alesimattia/Weather-Station-IN_OUT-Esp32-WiFi-IAQ/docs/ESP32_38 pin.jpg

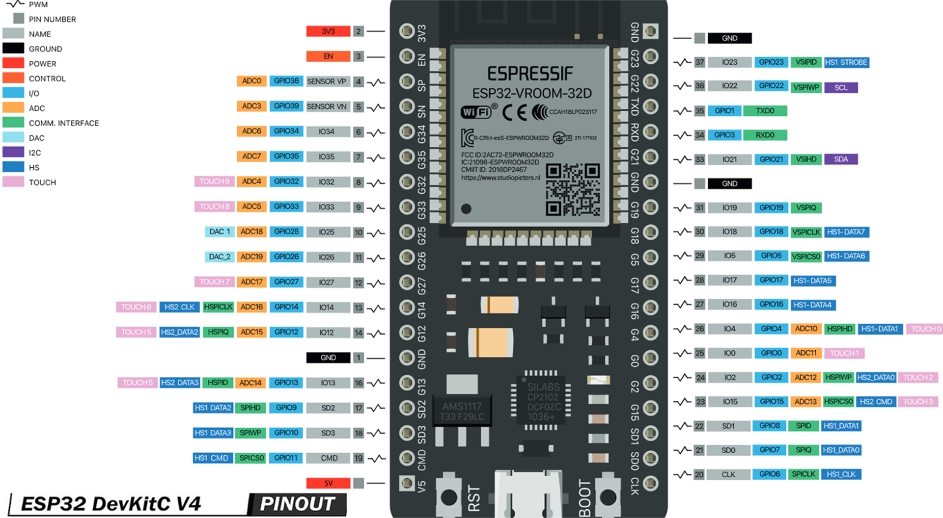
docs/ESP32_38 pin.jpg
