alesimattia/Weather-Station-IN_OUT-Esp32-WiFi-IAQ/docs/ESP32_DevKitC-v4-pinout.jpg

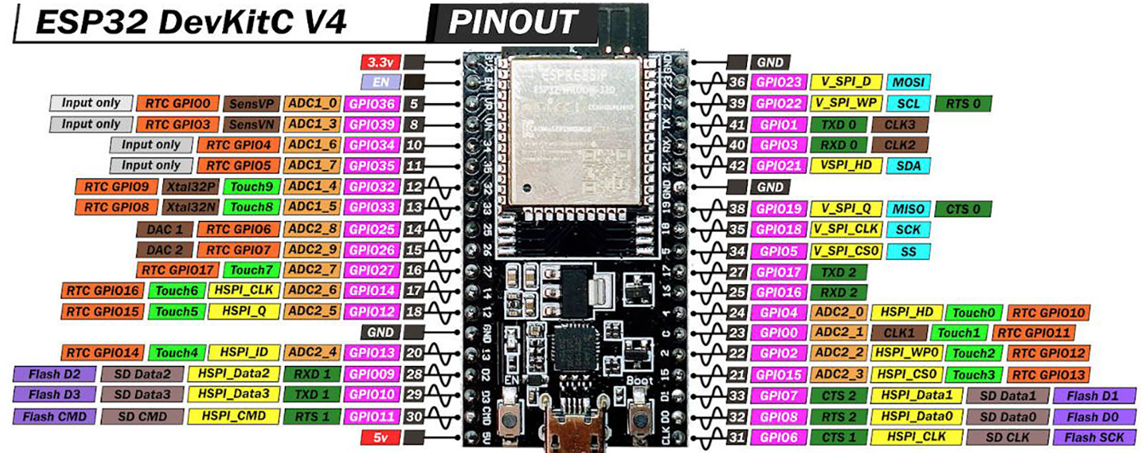
docs/ESP32_DevKitC-v4-pinout.jpg
