alesimattia/Weather-Station-IN_OUT-Esp32-WiFi-IAQ/docs/img/air_quality_index.jpg

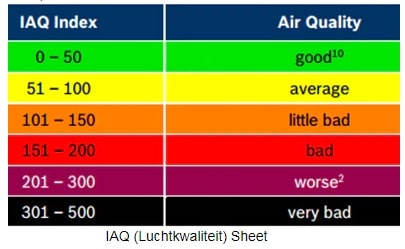
docs/img/air_quality_index.jpg
