alesimattia/Weather-Station-IN_OUT-Esp32-WiFi-IAQ/docs/img/air_quality_ppm.jpg

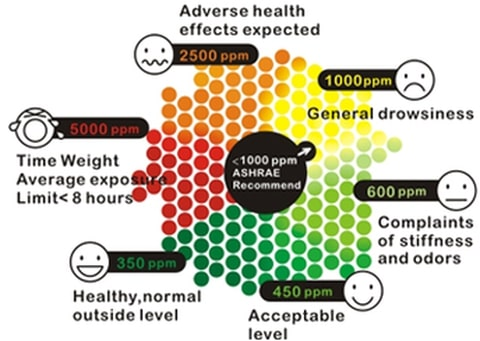
docs/img/air_quality_ppm.jpg
