alesimattia/Weather-Station-IN_OUT-Esp32-WiFi-IAQ/docs/img/bmp280 use cases.jpg

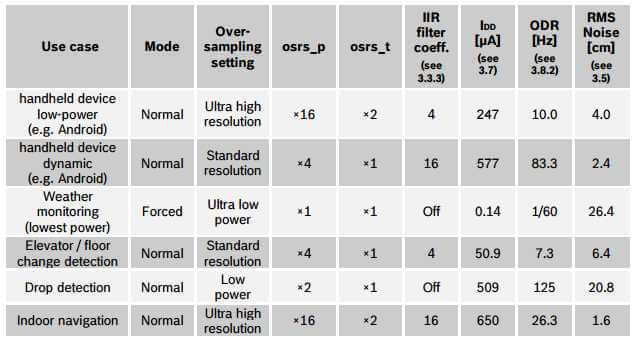
docs/img/bmp280 use cases.jpg
