alesimattia/Weather-Station-IN_OUT-Esp32-WiFi-IAQ/docs/img/board1.JPG

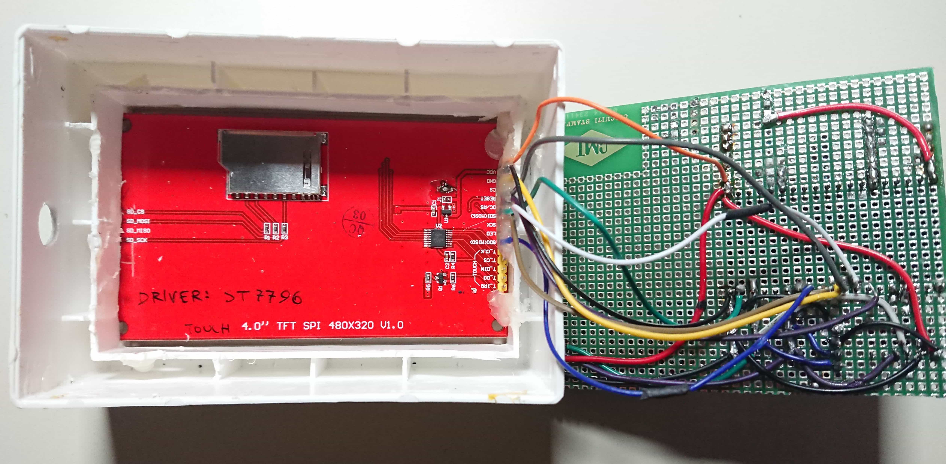
docs/img/board1.JPG
