alesimattia/Weather-Station-IN_OUT-Esp32-WiFi-IAQ/docs/img/board.JPG

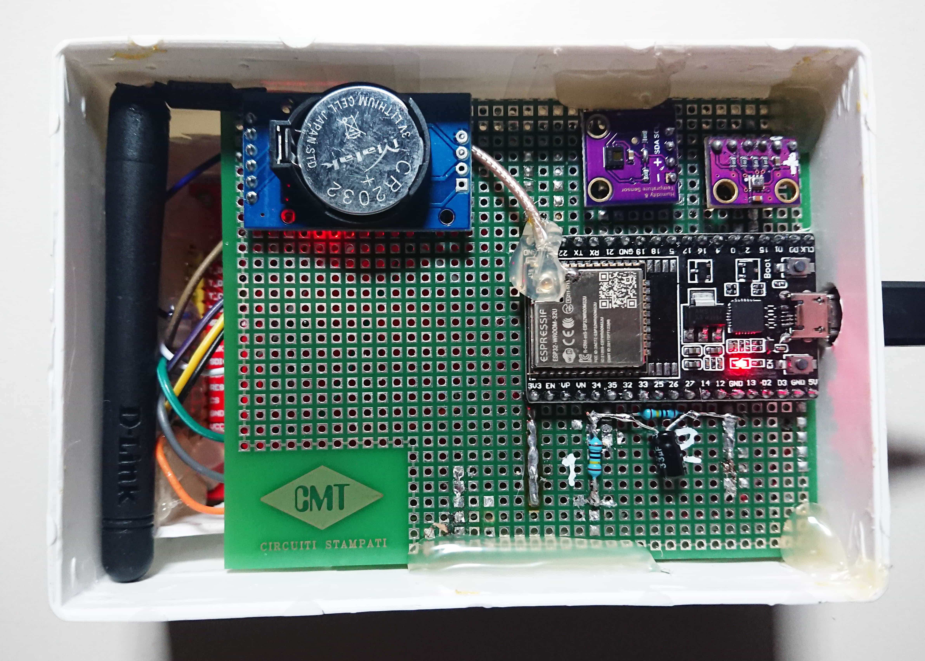
docs/img/board.JPG
