alesimattia/Weather-Station-IN_OUT-Esp32-WiFi-IAQ/docs/img/display.JPG

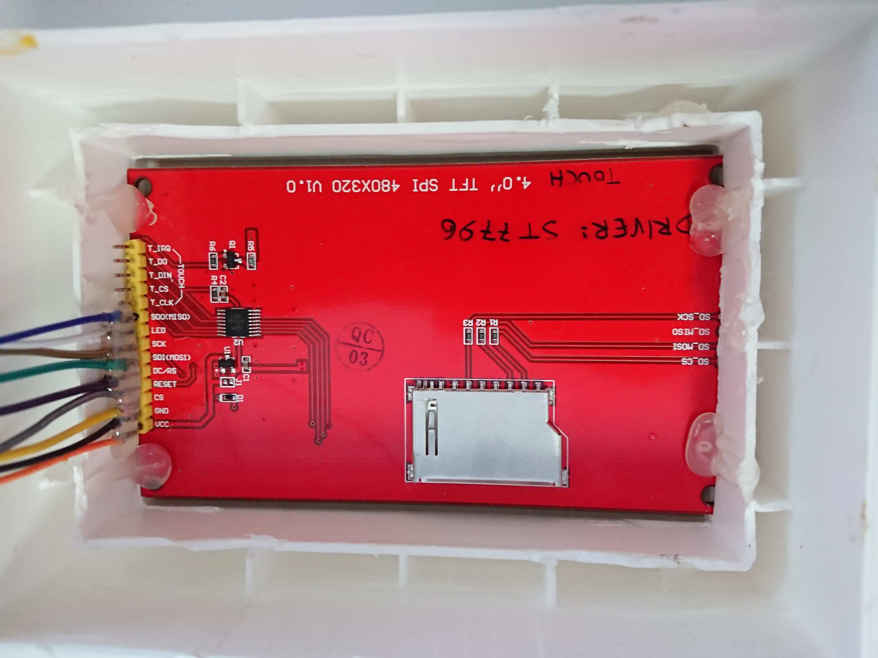
docs/img/display.JPG
