alesimattia/Weather-Station-IN_OUT-Esp32-WiFi-IAQ/docs/img/DSC_1557.JPG

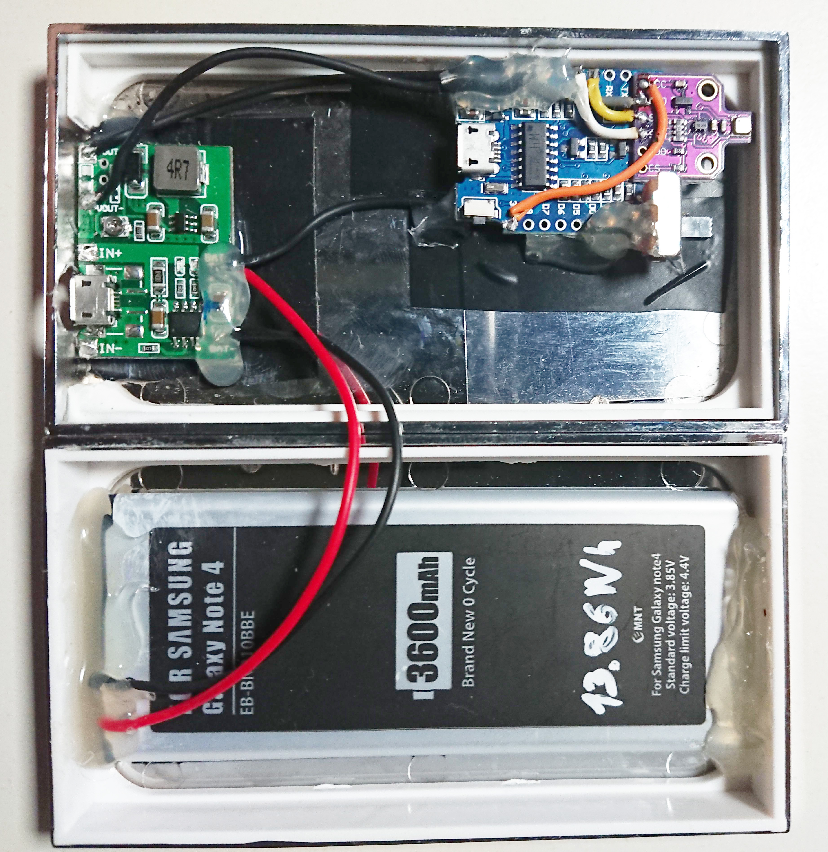
docs/img/DSC_1557.JPG
