alesimattia/Weather-Station-IN_OUT-Esp32-WiFi-IAQ/docs/img/early_ui.JPG

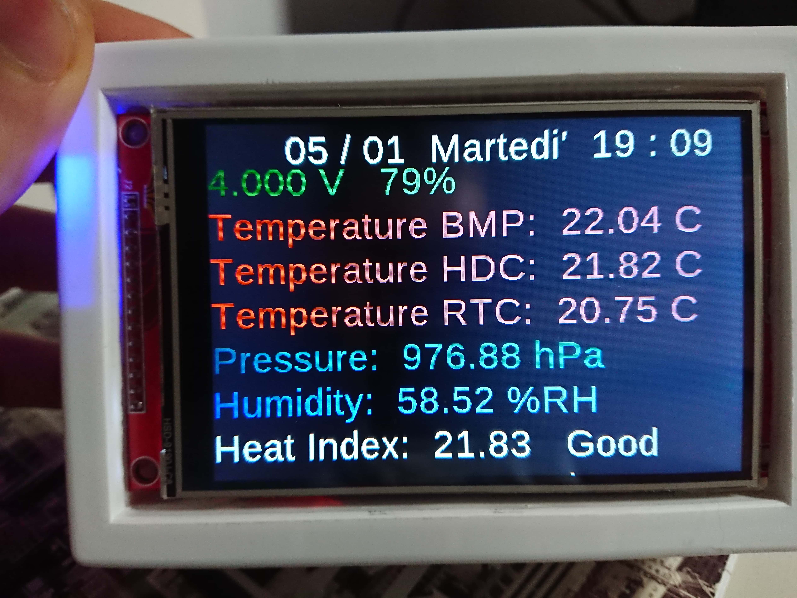
docs/img/early_ui.JPG
