alesimattia/Weather-Station-IN_OUT-Esp32-WiFi-IAQ/docs/img/sleep_modes_8266.jpg

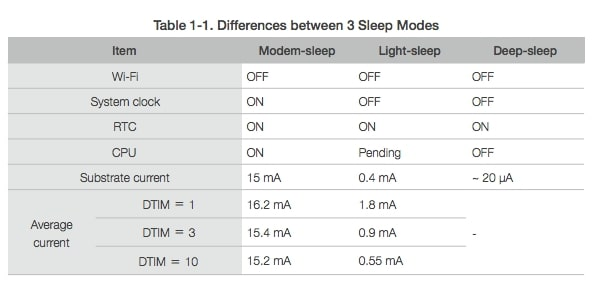
docs/img/sleep_modes_8266.jpg
