alesimattia/Weather-Station-IN_OUT-Esp32-WiFi-IAQ/docs/img/wifi_powe_consumption_8266.jpg

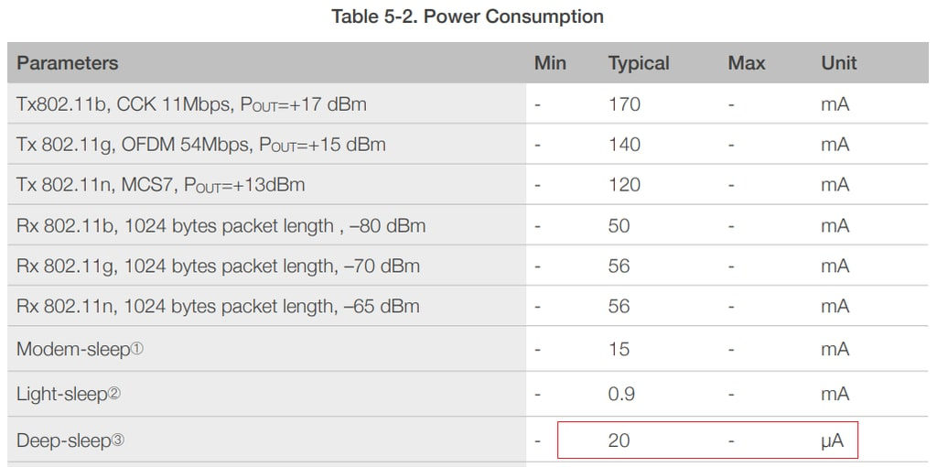
docs/img/wifi_powe_consumption_8266.jpg
