alesimattia/Weather-Station-IN_OUT-Esp32-WiFi-IAQ/docs/img/test1.JPG

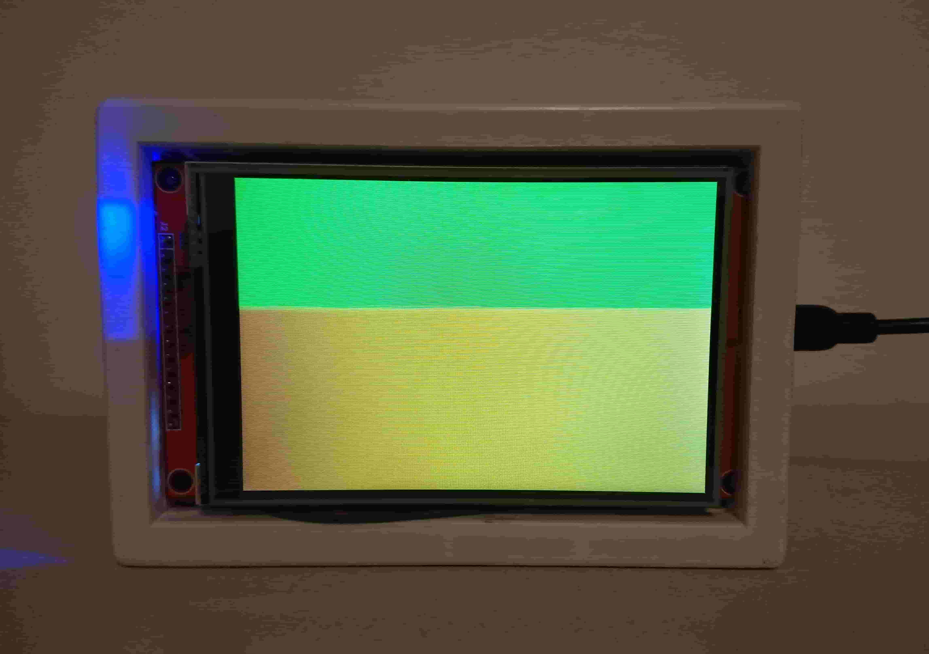
docs/img/test1.JPG
