alesimattia/Weather-Station-IN_OUT-Esp32-WiFi-IAQ/docs/img/test2.JPG

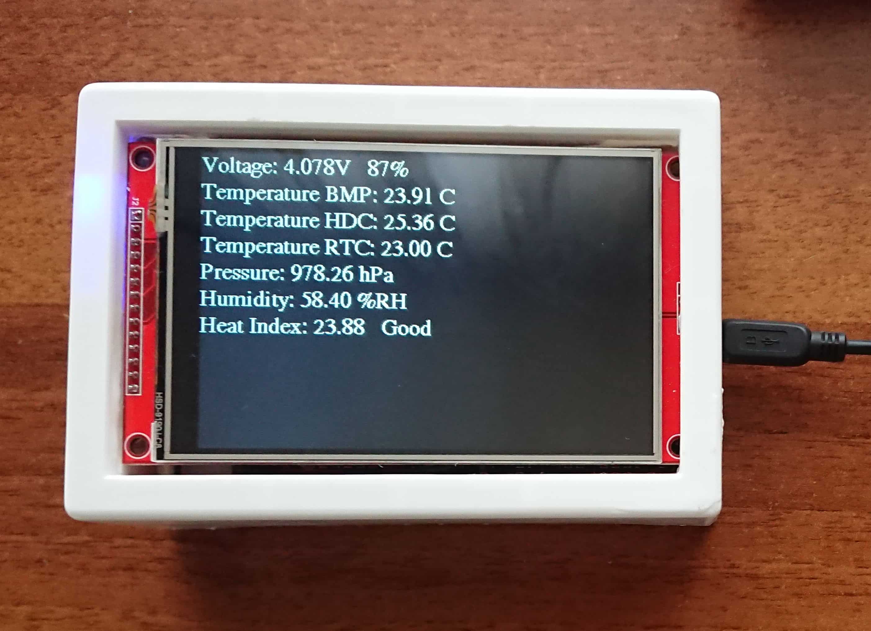
docs/img/test2.JPG
