alesimattia/Weather-Station-IN_OUT-Esp32-WiFi-IAQ/Custom_font.h

// Created by http://oleddisplay.squix.ch/ Consider a donation


/** Best font. located in main project directory. #include "Custom_font.h" */

/******************************************* GENERAL USAGE (Date and sensor data) **************************************************************/

const uint8_t URW_Gothic_L_Book_41Bitmaps[] PROGMEM = {

	// Bitmap Data:
	0x00, // ' '
	0xEE,0xEE,0xEE,0xEE,0xEE,0xEE,0xEE,0xEE,0xEE,0xEE,0xEE,0x00,0x0E,0xEE,0xEE, // '!'
	0xC6,0xC6,0xC6,0xC6,0xC6,0xC6,0xC6,0xC6,0xC6, // '"'
	0x00,0xC0,0x70,0x01,0x80,0xC0,0x07,0x01,0x80,0x0E,0x07,0x00,0x1C,0x0E,0x00,0x30,0x1C,0x00,0x60,0x30,0x01,0xC0,0x60,0x7F,0xFF,0xFC,0xFF,0xFF,0xF9,0xFF,0xFF,0xF0,0x18,0x0E,0x00,0x30,0x18,0x00,0xE0,0x30,0x01,0xC0,0xE0,0x03,0x81,0xC0,0x06,0x03,0x81,0xFF,0xFF,0xF3,0xFF,0xFF,0xE7,0xFF,0xFF,0xC0,0xE0,0x70,0x01,0xC0,0xE0,0x03,0x01,0xC0,0x06,0x03,0x00,0x1C,0x06,0x00,0x38,0x1C,0x00,0x70,0x38,0x00,0xC0,0x70,0x01,0x80,0xE0,0x07,0x01,0x80,0x00, // '#'
	0x01,0xC0,0x00,0xE0,0x00,0x70,0x00,0x3C,0x00,0xFF,0x80,0xFF,0xE0,0xF0,0x78,0x70,0x1C,0x70,0x07,0x38,0x03,0x9C,0x01,0xCE,0x00,0x07,0x00,0x01,0xC0,0x00,0xF0,0x00,0x3F,0x00,0x0F,0xF0,0x01,0xFC,0x00,0x1F,0x00,0x03,0xC0,0x00,0xE0,0x00,0x38,0x00,0x1D,0xC0,0x0E,0xE0,0x07,0x70,0x03,0xBC,0x03,0xCE,0x01,0xC7,0xC3,0xE1,0xFF,0xE0,0x3F,0xE0,0x03,0x80,0x01,0xC0,0x00,0xE0,0x00,0x70,0x00, // '$'
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
	  {  7652,  32,  57,  42,    6,  -57 }, // 'E'
	  {  7880,  30,  57,  38,    6,  -57 }, // 'F'
	  {  8094,  61,  59,  68,    3,  -58 }, // 'G'
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
};
const GFXfont URW_Gothic_L_Book_77 PROGMEM = {
(uint8_t  *)URW_Gothic_L_Book_77Bitmaps,(GFXglyph *)URW_Gothic_L_Book_77Glyphs,0x20, 0x7E, 95};
