alesimattia/Weather-Station-IN_OUT-Esp32-WiFi-IAQ/(commit log)

2020-11-17 First upload
    First implementation with a working RTC clock and BMP280 (to replace)
    - Completing the voltage divider to estimate battery level.
    [Weather-station-wifi.ino]
2020-11-19 Unbundled result
    - Unbundled calculations & sensor readings from the calling function.
    - Global variables holds the data -> then a specific function will print to the TFT screen
2020-11-23 Battery voltage
    - Completed battery voltage measurement with tension and percentage.
    It's also been hardware implemented.
    - Still need to fix RF 433 transmission
    [Weather-station-wifi.ino]
2020-11-25 EXTERNAL SENSOR
    - Added external sensor code (ESP8266 D1 Mini)
    - Few voltage improvements
    - Removed RF chip
    The COMMUNICATION will be via wifi and no more with RF.
2020-11-27 WIFI server
    - Completed external sensor
    - Reacheable via wifi lan //192.168.4.1
    This wireless-probe is capable of read and send exteral ambient measurements via HTTP request.
    Still waiting for the BME680 (temp, press, hum, airQuality) to complete de final version of the code.
    At the moment I've just got a BMP280
2020-11-29 Sensor Sleep
    Added the extenal sensor sleep function to preserve battery.
    - Need to sync ext_sensor with weatherStation optimally
2020-11-29 Deep Sleep
    - Sleep working correctly (timings to be defined)
    **Assembled all components in an enclosure box**
    (with BMP280; still waiting for the BME680)
    [ext_sensor.ino]
2020-12-01 Minor Fix
    - Updated doc. comments
    - Fixed sleep/wakeup
    - Better Battery measurement calibration
    [ext_sensor.ino]
2020-12-19 Class Diagram
    - Class diagram
    - Finally got BME680, HDC1080 and TFT Display
    - Added BMP calibration and sleep function
2020-12-25 Humidity Sensor
    - Added HDC1080 humidity sensor
    - Calculating heat-index with also textual evaluation
    - Moved documentation files to "doc" folder
    - Fixed sensor temperature readings
    - Small improvements
    [Weather-station-wifi.ino, ext_sensor.ino]
2021-01-02 Wired the display
    - Wired the 4.0" ST7796 TFT screen
    - Implemented screen code
    Striving with the GFX library to display an image instead of a drawing
2021-01-03 Displaying IMAGES!
    - Managed to displaying real images (and not screen-fillings)
    - Started to display text (sensor data)
2021-01-05 Documentation improvements
    - Readme in writing
    - Hardware SPI for display
    - Clock adjustment improvements
    - Voltage reading correction (main)
    - Removed test image
    - Added custom font (find in /docs)
    [Weather-station-wifi.ino, ext_sensor.ino]
2021-01-06 Before changin tft library
    Good screen layout.
    At the moment is not showing external sensor data.
    - Trying to switch to TFT_eSPI display library.
2021-01-09 Display library changed
    - Switched to display library TFT_eSPI
    It's insanely faster compared to Adafruit_GFX
    - Custom font header file in ./docs to copy in TFT_eSPI main folder
2021-01-18 Started syncing
    Almost definitive UI layout.
    - Started the process of syncing ext_sensor with wStation.
    - Few battery-saving careness.
    - Added some icons for weather forecast (.psd)
2021-01-20 Code cleaned
    Good sync with espNow.
    - Few battery reading fix (and phisically installed a capacitor to stabilize readings)
    Need to implement SLEEP!
    [Weather-station-wifi.ino, ext_sensor.ino]
2021-01-22 Fixed BSEC compiling
    - Pre-compiled BSEC library fixed:
    https://community.bosch-sensortec.com/t5/MEMS-sensors-forum/Error-compiling-BSEC-on-ESP8266-with-Arduino-IDE/td-p/13571
    - EspNow last test: next communication pattern will go be HTTP requests.
    As long as I get a good and stable sync I will go using BSEC
    [Custom_font.h, User_Setup.h, Weather-station-wifi.ino, ext_sensor.ino]
2021-01-24 SoftAP connection
    - Implemented HTTP GET requests data sending to wStation.
    - ext_sensor correctly sleeping after data sending
    Still trying to calibrate well battery and temperatures
    [Weather-station-wifi.ino, ext_sensor.ino]
2021-01-31 Start Weather Forecast
    - Started the process of getting a w.forecast by OpenWeatherMap.com
    - Need to parse the response payload
    - Good wireless communication
    - Battery calibration (wStation)
    - Indoor calibration
2021-02-12 Air quality calculations
    - Compiling and working BSEC library
    - Battery measurements perfectly calibrated (I got a new multimeter)
2021-02-16 Store in Flash
    - Storing BSEC status in flash
    Need more documentation on how to compute IAQ
    - Battery calibration (ext_sensor) at full voltage
2021-02-19 Backup
    Trying to implement bme680 IAQ measurement.
    - Need to save the current working state.
2021-03-15 Internet connection
    - Trying to get an internet forecast to display to the screen
    - Trying to feed BSEC (Air quality) routine with a relevant timestamp.
    Even with an emmc state storing, computing is not done correctly
    [Weather-station-wifi.ino, Weather_icons.h, ext_sensor.ino]
2021-03-28 Wifi forecast downloading
    - Wifi internet connection (with DNS) and forecast-downloading are working correctly.
    - Parsing of the http Json response is working and then is stored in a variable.
    [Weather-station-wifi.ino]
2021-04-28 AIR QUALITY working!!!
    - State of the BSEC saved correctly to emmc
    - Managed to feed BSEC with absolute timestamp (saved to emmc)
    - Minor UI changes
    - Updated documentation
    - Added few immages
    [Weather-station-wifi.ino, ext_sensor.ino]
2021-04-30 IAQ fix
    It's MANDATORY to have ALL those virtual sensors to compute air quality index
    [Weather-station-wifi.ino, ext_sensor.ino]
2021-10-13 Fixed BUG
    NEVER DO bme.reset()
    Bootloop occours
    - Code cleaning
    - Readme updated
    - Corrected "User_setup.h" backup file in /docs
    - Restored uploading of /.vscode compilation settings file
    [User_Setup.h, Weather-station-wifi.ino, ext_sensor.ino]
2022-03-27 CEST timezone
    Uploading code on the board to update the clock timezone (GMT+1 -> +2)
    Switched to DHTesp for HeatIndex calculations
